straytech/Bliptronome/V3_PinConnections.jpg

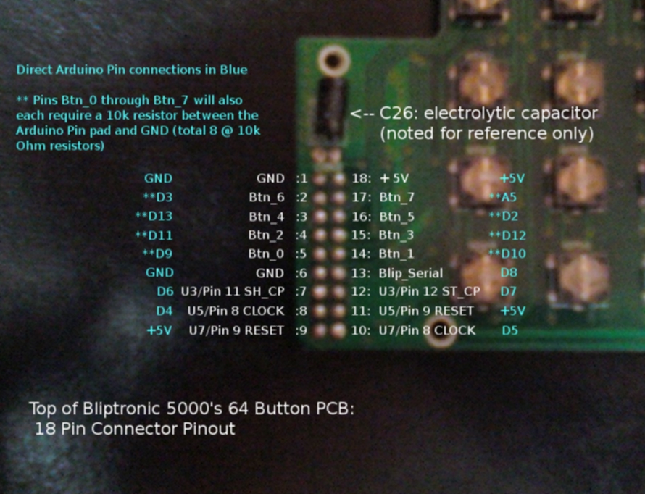
V3_PinConnections.jpg
