straytech/Bliptronome/(threads)

Thread 1 (2022-06-28):

Please Help! Big Sur can't open arduinome serial!

fabandroid, 2022-06-28:
I'm using your device since the beginning very good and portable. Now arduinome serial is not working.
hairless-midiserial is working on big sur but I have an error connecting the bliptronome.
I need just to have the buttons like midi notes and the 4 knob like CC also a fix patch will be ok.
Please help me! I need something fast to work with.
